requireiot/MyMotionSensor/pictures/MyMotionSensor PCB Bottom.jpg

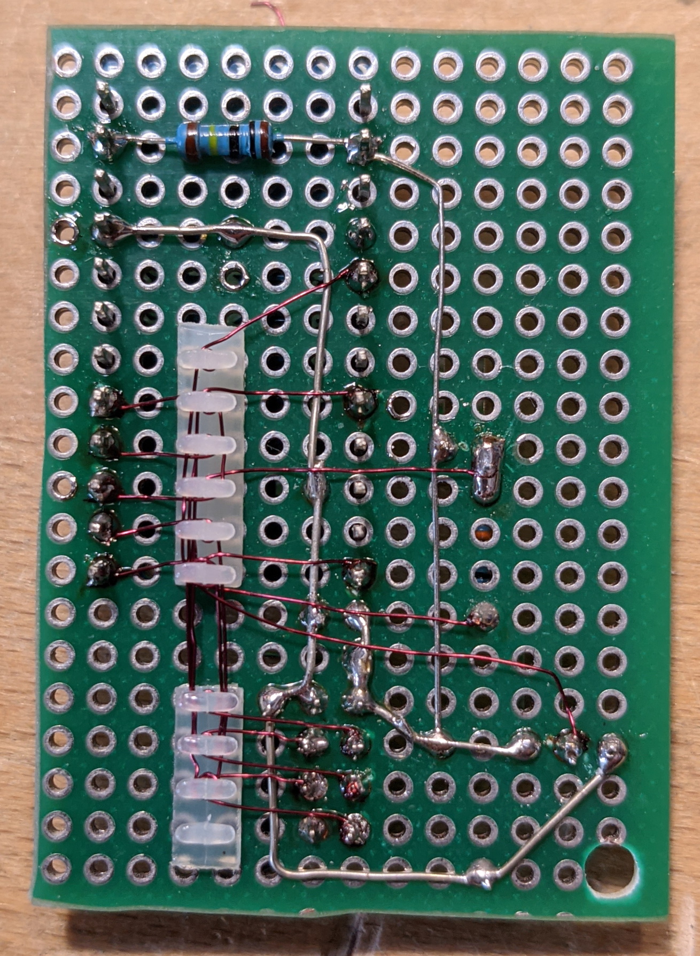
pictures/MyMotionSensor PCB Bottom.jpg
