requireiot/MyMotionSensor/pictures/MyMotionSensor PCB Top no NRF.jpg

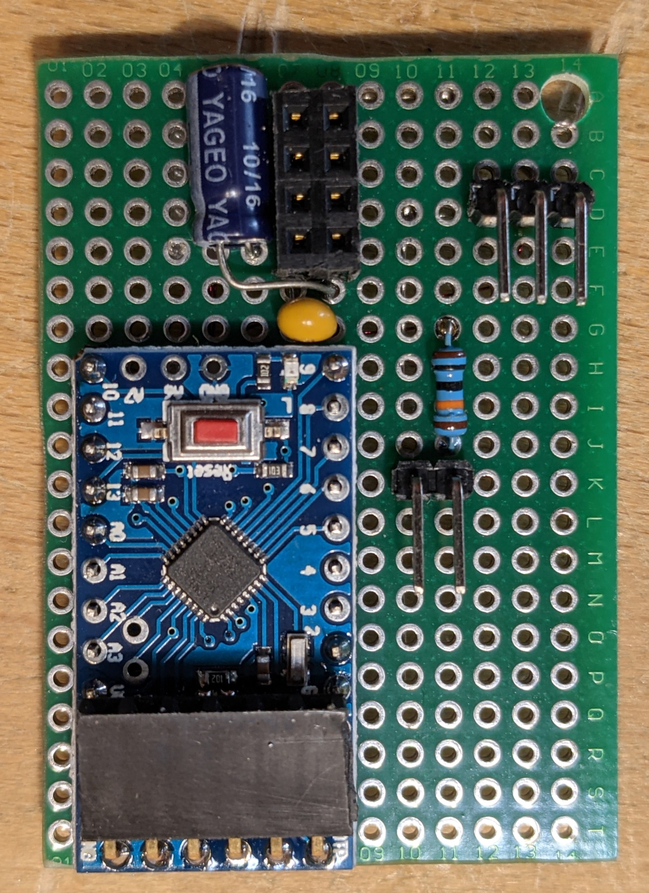
pictures/MyMotionSensor PCB Top no NRF.jpg
