requireiot/MyMotionSensor/pictures/MyMotionSensor PCB Top.jpg

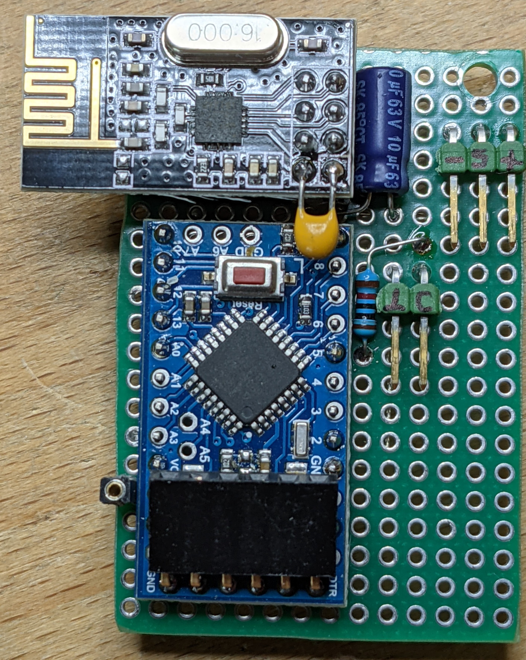
pictures/MyMotionSensor PCB Top.jpg
