requireiot/MyMotionSensor/hardware/BOM MyMotionSensor.xlsx

 |  |  |  |  | 6.30 €
 | Price/lot | units/lot | price/unit | units | price
White DYI case | 5.21 € | 5 | 1.04 € | 1 | 1.04 € | Aliexpress https://www.aliexpress.com/item/32920588870.html
Battery holder 2xAA | 2.01 € | 10 | 0.20 € | 1 | 0.20 € | Aliexpress https://www.aliexpress.com/item/32668159341.html
HC-SR505 |  |  | 1.02 € | 1 | 1.02 € | Aliexpress https://www.aliexpress.com/item/1005001698642117.html
BPW40 |  |  | 0.29 € | 1 | 0.29 € | Reichelt
Protoboard 4x6 | 2.57 € | 10 | 0.26 € | 1 | 0.26 € | Aliexpress
Wiring comb | 15.00 € | 25 | 0.29 € | 0.5 | 0.14 € | eBay 380641318519
Pin header female 2x4 | 0.99 € | 5 | 0.20 € | 1 | 0.20 € | Reichelt BL 2X25G 2,54
Pin header female 1x6 | 1.93 € | 50 | 0.04 € | 1 | 0.04 €
ATmega328 Pro Mini 3.3V | 23.41 € | 10 | 2.34 € | 1 | 2.34 € | Aliexpress https://www.aliexpress.com/item/32950062240.html
NRF24L01+ | 6.58 € | 10 | 0.66 € | 1 | 0.66 € | http://www.ebay.de/itm/272445594826
10uF | 1.00 € | 25 | 0.04 € | 1 | 0.04 € | Reichelt RAD 10/63
100nF | 1.00 € | 50 | 0.02 € | 1 | 0.02 € | http://www.ebay.de/itm/272304214655
10 kOhm 1% | 2.50 € | 100 | 0.03 € | 1 | 0.03 € | Reichelt METALL 10,0K
1 Mohm | 2.50 € | 100 | 0.03 € | 1 | 0.03 €
