requireiot/MyMotionSensor/hardware/MyMotionSensor.pdf

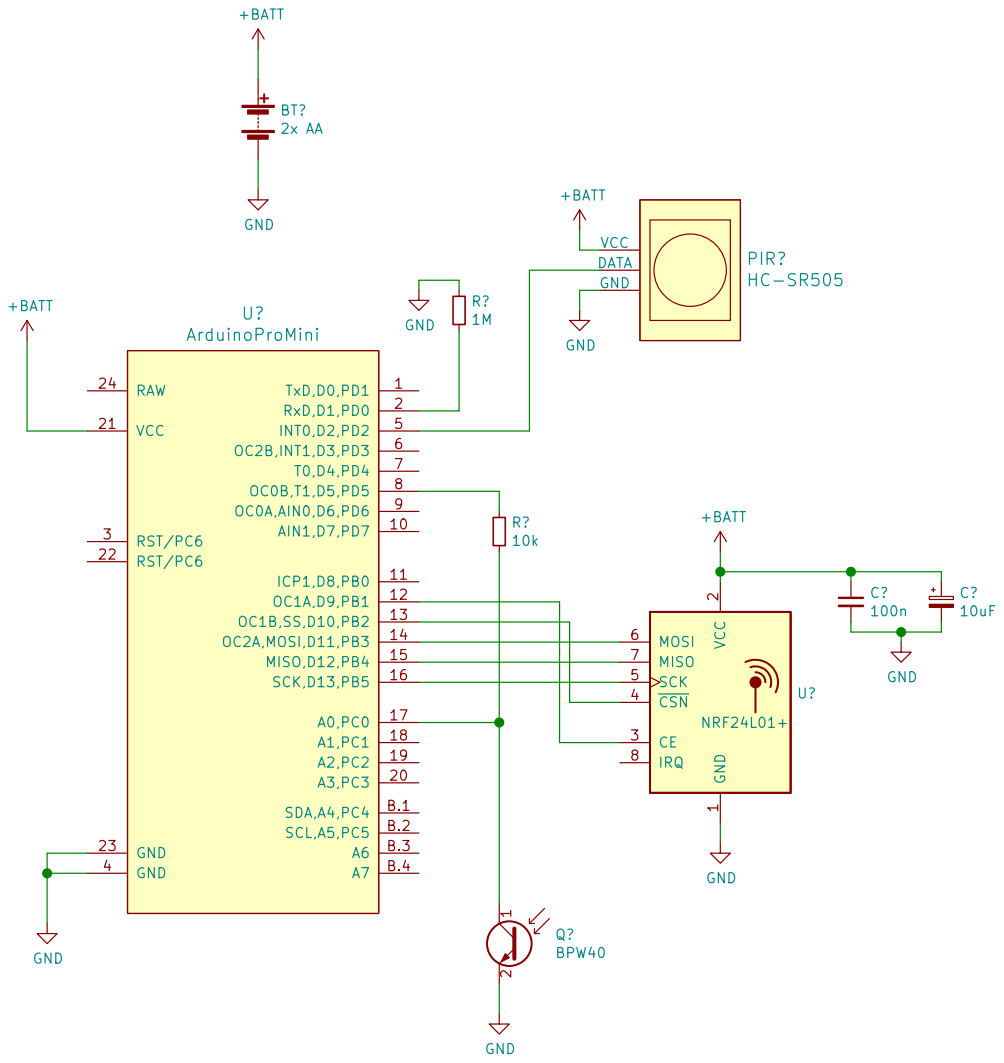
[picture p7: page 1]

2 CE 3 CSN 4 SCK 5 MOSI 6 MISO 7

File: MyMotionSensor.sch Sheet: /
Id: 1/1 Title: MyMotionSensor
