requireiot/MyMotionSensor/src/mysensors_conf.h

#ifndef __MYSENSORS_CONF_H
#define __MYSENSORS_CONF_H

#define MY_BAUD_RATE 9600

// Enable debug prints
//#define MY_DEBUG
//#define MY_DEBUG_VERBOSE_RF24
#define MY_SPLASH_SCREEN_DISABLED

// Enable and select radio type attached
#define MY_RADIO_RF24
//#define MY_RADIO_RFM69

#include "node-id.h"

#endif // __MYSENSORS_CONF_H
